DesignStraub/ringwheel-hybrid-drone/docs/Kostenliste.md

# Kostenliste Hybrid-Drohne (Stand 26.10.2026, mit FPV-Kamera und Fahrgetriebe 1:4)

Preise inkl. 19 % MwSt., ohne Versand, wenn nicht anders vermerkt. Live von den Shopseiten abgerufen; nichts bestellt.
USD-Preise umgerechnet mit 1 EUR = 1,1193 USD (EZB, 23.10.2026).
**verifiziert** = Preis auf der Produktseite gesehen, **Suchliste** = Preis aus der Shop-Suche, **geschätzt** = kein Seitenpreis.

## Pflichtteile

| # | Menge | Produkt | Shop | € gesamt | Status |
|---|---|---|---|---|---|
| 1 | 4 | iFlight XING 2306 2450KV (4S) | [FPV24](https://www.fpv24.com/en/iflight/iflight-xing-2306-2450kv-4s-unibell-camo-racing-motor) | 62,00 | verifiziert |
| 2 | 2 Sätze | Gemfan Hurricane 51466-3 (5,1", 3-Blatt) | [FPV24](https://www.fpv24.com/en/gemfan/gemfan-hurricane-mck-51466-3-3-blade-propeller-51-inch-wave-blue) | 5,98 | verifiziert |
| 3 | 1 | Flywoo GOKU F722 Pro V2 55A Stack 30×30 (AM32 oder BLHeli_32) | [N-Factory](https://n-factory.de/Flywoo-GOKU-F722-Pro-V2-55A-30x30-AM32-Stack-3-6S) | 88,90 | verifiziert |
| 4 | 1 | BetaFPV ELRS Nano Empfänger | [FPV24](https://www.fpv24.com/de/betafpv/betafpv-elrs-nano-receiver) | 12,50 | verifiziert |
| 5 | 2 | BosLipo P7 4S 1300 mAh XT60 | [FPV24](https://www.fpv24.com/de/boslipo/boslipo-p7-batterie-1300mah-148v-4s-150c-lipo-akku-xt60-plug) | 57,80 | verifiziert |
| 6 | 2× 2er-Pack | N20-Getriebemotor 6 V, 300 U/min | [Amazon](https://www.amazon.de/dp/B0HNJ9TCYX) | 26,86 | verifiziert |
| 7 | 4 Sätze | **Empfohlen:** Messing-Schneckengetriebe M0,5, 1:30 (passt exakt zur Konstruktion) | [AliExpress](https://de.aliexpress.com/item/1005008696341485.html) | ≈ 47,08 | verifiziert, + Zoll |
| 7 alt. | je 4 | Mädler Schnecke Stahl 30000000 + Schneckenrad Bronze 25 Z 30001000 (i = 25, 17 % weniger Moment) | [Mädler](https://www.maedler.de/Article/30001000) | 144,84 | verifiziert, netto + MwSt. |
| 8 | 1 m | Alu-Rundrohr 12×1 | [Hornbach](https://www.hornbach.de/p/rundrohr-alu-natur-o-12-mm-1-m/8829152/) | 3,65 | verifiziert |
| 9 | 300 mm | Welle 6 mm h6 (gehärtet; ungehärtet C45 1 m: 9,78 €) | [Amazon](https://www.amazon.de/dp/B07GKJJZXK) | 5,34 | verifiziert |
| 10a | 10 Stk | Neodym diametral Ø 6×2 (für AS5600) | [AliExpress](https://de.aliexpress.com/item/1005012687239354.html) | 2,69 | Variantenpreis nicht geprüft |
| 10b | 4 Stk | Ringmagnet NdFeB axial ca. Ø 16 × Ø 12,5 × 1 mm (Hall-Geber auf der Muffennabe; ersatzweise 6 Scheiben Ø 1,5 × 1 mm je Muffe) | – | ≈ 6 | **geschätzt**, genaue Größe in keinem Shop gefunden |
| 10c | 12 Stk | Zylinderstift Ø 2,5 × 8 mm, ISO 8734 (Planetenbolzen) | – | ≈ 5 | **geschätzt** |
| 11 | 100 g | Kupferlackdraht 0,25 mm (Hubmagnet-Spulen) | [Amazon](https://www.amazon.de/dp/B08CVHQH67) | 13,99 | verifiziert |
| 12 | 5 Stk | Scheiben DIN 125 M12 Stahl (Anker) | [Amazon](https://www.amazon.de/dp/B0CJZFXLSX) | 4,11 | verifiziert |
| 13 | 5 Stk | Druckfeder 1,0 × AD 20 × 25 mm | [Amazon](https://www.amazon.de/dp/B0CL9SKV5J) | 5,69 | verifiziert |
| 14 | 4 | igus iglidur G GSM-1214-10 (Gleitlager Muffe) | [igus](https://www.igus.de/iglidur-ibh/zylindrische-gleitlager/product-details/iglidur-g-m?artnr=GSM-1214-10) | 12,09 | verifiziert, netto + MwSt. |
| 15 | 1 | Nylon-Schrauben/Abstandsbolzen-Sortiment M2–M4 | [Amazon](https://www.amazon.de/dp/B0CLD4DVVY) | 16,99 | verifiziert |
| 16a | 1 | Silikonkabel 20 AWG rot/schwarz | [Amazon](https://www.amazon.de/dp/B0CRVN1QTY) | 6,49 | verifiziert |
| 16b | 1 | Silikonkabel 28 AWG rot/schwarz | [Amazon](https://www.amazon.de/dp/B0CRVKW33H) | 6,49 | verifiziert |
| 16c | 1 Kit | JST-GH 1,25 Kit (vorgecrimpt, Gehäuse 2–10 pol) | [Amazon](https://www.amazon.de/dp/B07PBHN7TM) | 18,99 | verifiziert |
| 16d | 1 Kit | JST-SH 1,0 Kit (vorgecrimpt, Gehäuse 3–12 pol) | [Amazon](https://www.amazon.de/dp/B07PDQKHJ2) | 17,99 | verifiziert |
| 16e | 1 Paar | XT60H | [Amazon](https://www.amazon.de/dp/B07C3MCM8R) | 3,98 | verifiziert |
| 17a | 1 kg | Bambu Lab PA6-GF (Nylon, glasfaserverstärkt) | [3DJake](https://www.3djake.de/bambu-lab/pa6-gf-black) | 62,99 | Suchliste |
| 17b | 1 kg | Elegoo TPU 95A | [3DJake](https://www.3djake.de/elegoo/tpu-white-3) | 17,99 | Suchliste |
| 18 | | **Platinen + Bestückung JLCPCB**: Hybrid-Controller (4 Lagen, 2 bestückt), 5 Eckplatinen, DHL inkl. EUSt (Muffensensor MS-1 entfällt ab v13) | [JLCPCB](https://cart.jlcpcb.com/quote) | ≈ 230,49 | **geschätzt** |
| 18a | | Zuschlag Bestückung: Der fertige Hybrid-Controller hat 42 statt der angenommenen 32 Bauteiltypen | JLCPCB | ≈ 16 | **geschätzt** |
| 19 | 1 | **DJI O4 Air Unit Lite** (Kamera + Videosender, 9,95 g, 30 × 30 mm, 3,7–13,2 V) | [FPV24](https://fpv24.com/en/dji/dji-o4-air-unit-fpv-lufteinheit) | 115,00 | verifiziert 26.10., **derzeit nur vorbestellbar** |
| 20 | | Kleinkram: Akku-Klettband, Schrumpfschlauch, Lötzinn | – | ≈ 10 | **geschätzt** |

| Summe Drohne (alles, was verbaut wird) | € |
|---|---|
| Teile 1–17 mit AliExpress-Schneckengetrieben | ≈ 511 |
| Platinen JLCPCB inkl. Zuschlag (geschätzt) | ≈ 246 |
| FPV-Kamera und -Sender DJI O4 Lite | 115 |
| Kleinkram (geschätzt) | ≈ 10 |
| Versand übrige Shops + Zoll (geschätzt) | ≈ 29 |
| **Drohne gesamt (empfohlene Variante)** | **≈ 910 €** |
| Drohne gesamt mit Mädler-Getrieben | ≈ 1.010 € |

## Ausrüstung (nur falls noch nicht vorhanden)

| Produkt | Shop | € |
|---|---|---|
| **DJI Goggles N3** (FPV-Brille, passt zur O4) | [FPV24](https://www.fpv24.com/en/dji/dji-fpv-goggles-n3-video-goggles-hd) | 269,00 (verifiziert 26.10.; im Preisvergleich ab ca. 246 €) |
| RadioMaster Pocket CRUSH ELRS (ohne 18650-Akkus) | [FPV24](https://www.fpv24.com/en/radiomaster/radiomaster-pocket-crush-elrs-fpv-remote-control-slate-grey) | 84,90 |
| 2× 18650-Akku für die Pocket | – | ≈ 12 (geschätzt) |
| ToolkitRC M6AC Ladegerät mit Netzteil | [N-Factory](https://n-factory.de/ToolkitRC-M6AC-LiPo-1-6S-15A-AC-DC-charger-with-power-supply-unit) | 63,95 |
| **Summe Ausrüstung** | | **≈ 430 €** |

**Komplett mit Brille, Fernsteuerung und Ladegerät: ≈ 1.340 €.**

## Gegencheck 26.10.2026 (Design gegen diese Liste)

- **Platinen:** Die Stücklisten aus KiCad (Hybrid-Controller 97 Bauteile, Eckplatine 8, Muffensensor 2) passen 1:1 zu den Bestückungsdateien. Alle ICs und Stecker haben LCSC-Nummern. Für 26 Typen Kleinteile beim Hybrid-Controller (Widerstände, Kondensatoren, Dioden, Spule, Sicherung, USB-C, Taster) und 4 bei der Eckplatine wählt man die Teile im JLCPCB-Bestücktool aus. Fast alles davon sind „Basic Parts“ ohne Aufpreis.
- **Mechanik aus Fusion:** Alle gekauften Teile stehen in der Liste (Motoren, Propeller, N20, Schnecken und Räder, Bolzen aus der 6-mm-Welle, Alu-Rohr, Spulendraht, Anker-Scheiben, Federn, Gleitlager, Magnete, Stack, Empfänger, Akku). Die **vier Motorplatten** sind im Modell aus Alu, aber nicht in der Liste. Am einfachsten aus PA6-GF mitdrucken, das kostet nichts extra.
- **Via im Pad:** Bei den Pads unter dem ESP32, an C24 und U3 gibt es bei JLCPCB die Option „Via-in-Pad, gefüllt und abgedeckt“. Bei 4 Lagen kostet sie Aufpreis, den Betrag zeigt das Angebot. Man kann auch ohne bestellen und die zwei kleinen Lötstellen von Hand nacharbeiten.
- **Spannbreite:** JLCPCB-Coupons sparen 8–25 €. Ein 2er-Nutzen mit 4 statt 2 bestückten Controllern kostet bis zu 45 € mehr.
- **Fahrgetriebe (ab v13):** Sonne, Planeten, Hohlrad und die Radnabe mit Planetenträger werden aus dem PA6-GF mitgedruckt, das sind etwa 70 g mehr Nylon. Die Zähne haben Modul 0,7. Mit 0,4-mm-Düse geht das, mit 0,2-mm-Düse werden die Flanken sauberer. Gekauft werden nur Zylinderstifte und Ringmagnete (10b, 10c). Die Neodym-Scheiben Ø 3 × 2 für den alten Muffensensor entfallen.
- **Was übrig bleibt:** 3 unbestückte Controller-Platinen, 1 Eckplatine als Ersatz, ein zweiter Akku, ca. 680 g Nylon und 950 g TPU sowie die Sortimente.

## Platinen im Detail (JLCPCB, geschätzt)

| Platine | Lagen / Größe | Stück | € inkl. EUSt |
|---|---|---|---|
| Hybrid-Controller HC-1 | 4 Lagen, 62 × 42 mm | 5 PCB, 2 bestückt | ≈ 163 |
| Eckplatine EP-1 | 2 Lagen, 24 × 24 mm | 5 bestückt | ≈ 38 |
| Muffensensor MS-1 | entfällt ab v13 (Hall-Sensor sitzt einzeln in der Spulenbohrung) | – | 0 |
| Versand DHL + EUSt | | | ≈ 29 |

Bauteilkosten allein (LCSC, netto, nur zur Info, in der Bestückung enthalten): ≈ 42 €.

## Vor der Bestellung beachten

- **USB-C-Buchse:** Die ursprünglich geplante GCT USB4105 ist bei JLCPCB/LCSC ausverkauft. Im Design ist sie deshalb schon durch die **HRO TYPE-C-31-M-12** ersetzt (gängig, günstig; LCSC-Nummer beim Bestellen prüfen).
- **Mindestgröße Bestückung:** JLCPCB bestückt Standard-PCBA laut Capabilities erst ab 70 × 70 mm. Den Hybrid-Controller als 2er-Nutzen bestellen. Werden dabei 4 statt 2 Boards bestückt, kommen ca. 40–45 € dazu.
- **Knappe Teile:** ESP32-S3-MINI-1-N8, AP63200WU-7 (nur 266 Stück) und AS5600 gibt es nur noch bei JLCPCB, bei LCSC nicht.
- **Stack-Firmware:** Der Flywoo-Stack kommt je nach Charge mit AM32 oder BLHeli_32. Beide können Drehrichtungsumkehr per DShot und bidirektionales DShot. AM32 ist die zukunftssichere Wahl.
- **Zoll:** Seit 1.7.2026 fallen bei Sendungen unter 150 € pauschal 3 € Zoll pro Warenposition an (AliExpress). Die JLCPCB-Bestellung liegt darüber; dann zahlt man 19 % EUSt.
- **Netto-Shops:** Mädler und igus zeigen Nettopreise. Oben ist die MwSt. schon aufgeschlagen.
- **Coupons:** JLCPCB gibt regelmäßig Coupons aus (8–25 $). Die sind nicht eingerechnet.
