DesignStraub/ringwheel-hybrid-drone/docs/images/drive_gear_module.png

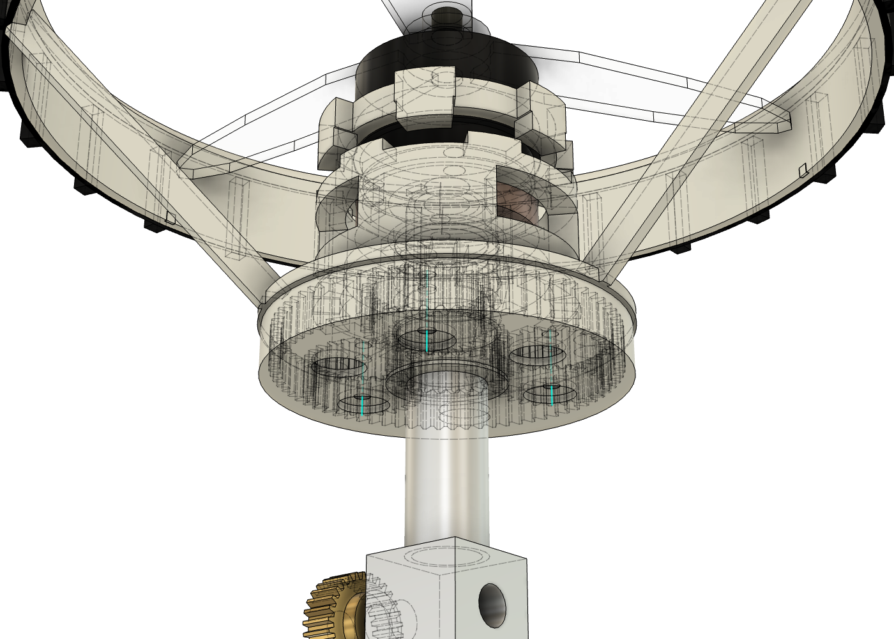
docs/images/drive_gear_module.png
