DesignStraub/ringwheel-hybrid-drone/docs/images/drive_gear_teeth.png

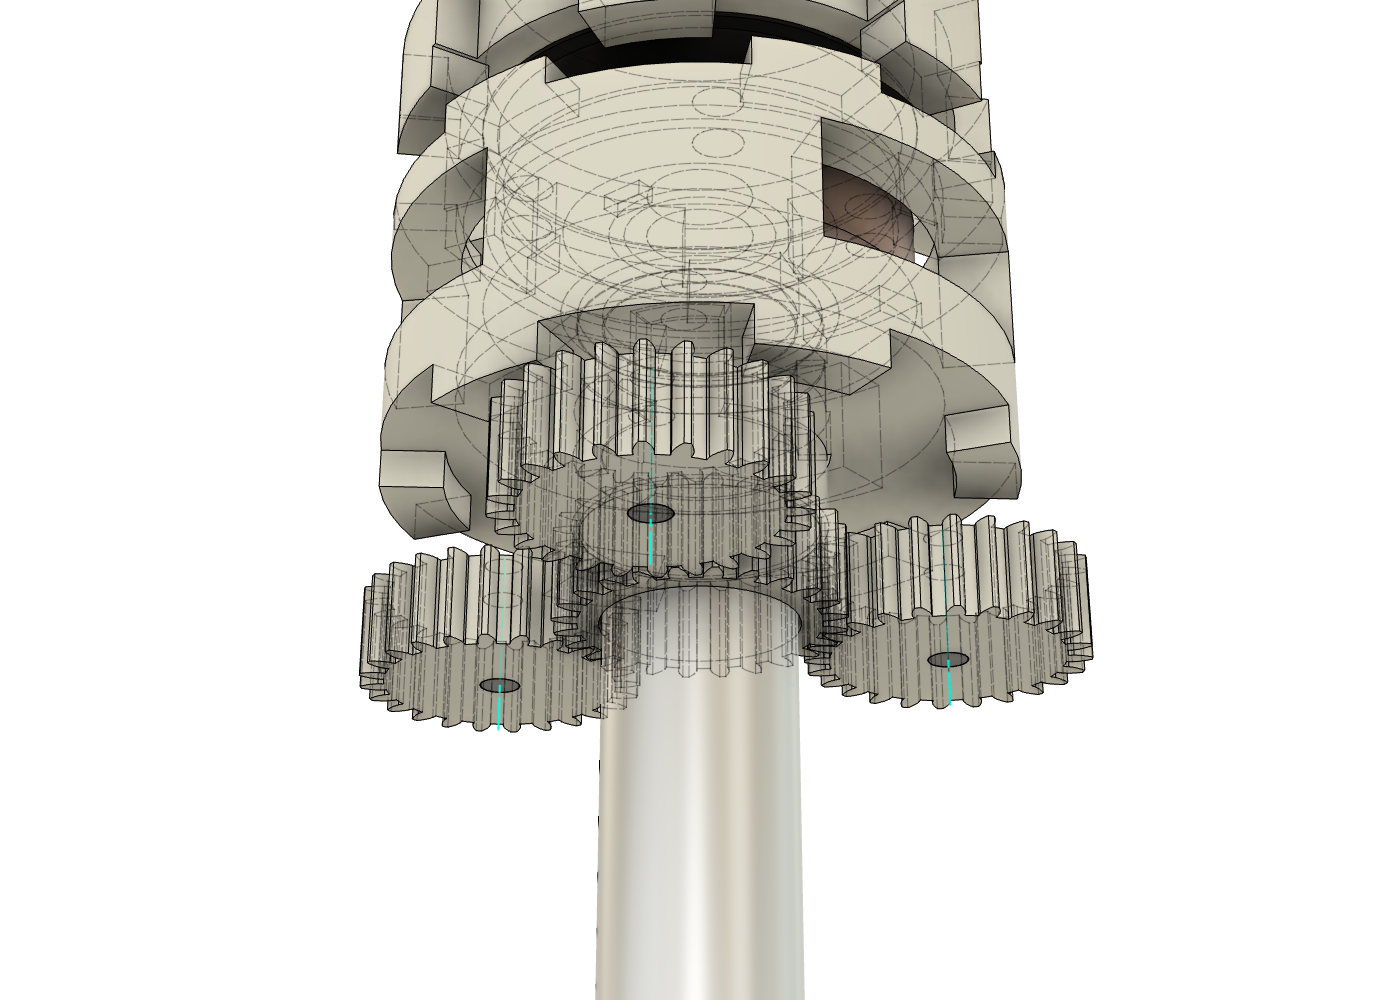
docs/images/drive_gear_teeth.png
