DesignStraub/ringwheel-hybrid-drone/electronics/Hybrid-Controller/HC-1_oben.png

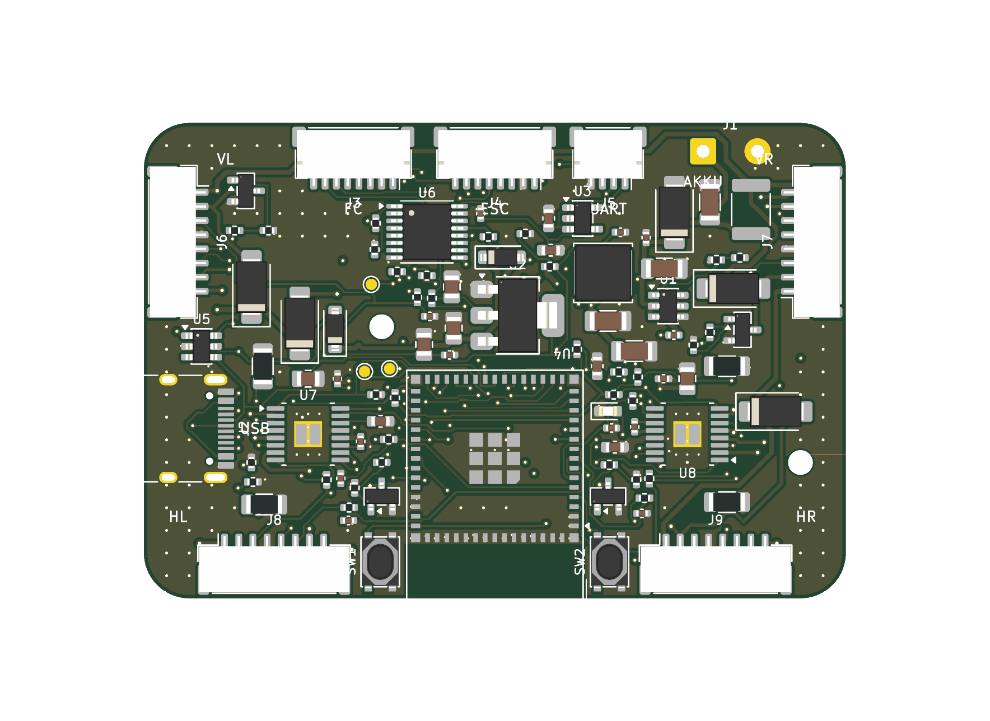
electronics/Hybrid-Controller/HC-1_oben.png
