DesignStraub/ringwheel-hybrid-drone/electronics/Hybrid-Controller/HC-1_unten.png

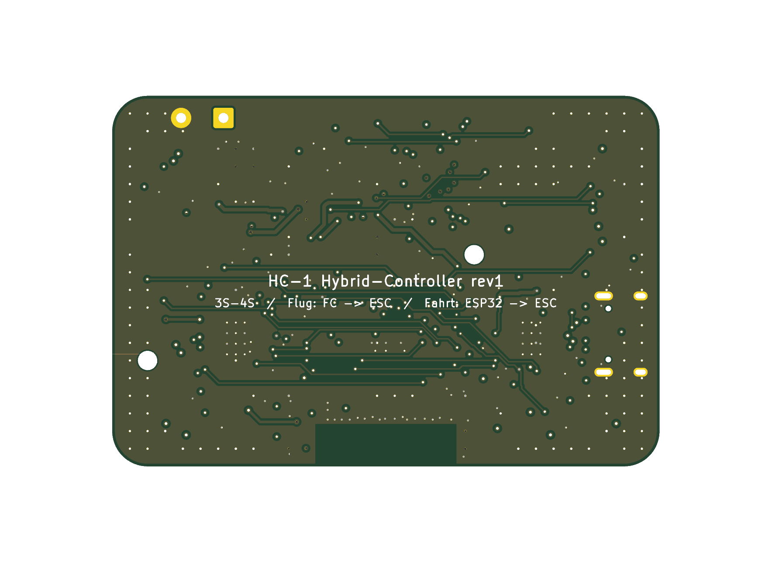
electronics/Hybrid-Controller/HC-1_unten.png
