DesignStraub/ringwheel-hybrid-drone/electronics/Fertigung/Hybrid-Controller_BOM_JLCPCB.csv

Comment | Designator | Footprint | LCSC Part #
10uF 35V | C1,C2 | C_1206_3216Metric
10uF | C11 | C_0805_2012Metric
10nF 16V | C16,C20 | C_0402_1005Metric
2.2uF | C17,C21 | C_0603_1608Metric
100nF 50V | C3 | C_0402_1005Metric
100nF | C4,C12,C13,C15,C19,C23,C24,C25,C26,C27,C28 | C_0402_1005Metric
22uF 16V | C5,C6 | C_1206_3216Metric
10uF 16V | C7,C18,C22 | C_0805_2012Metric
22uF 10V | C8 | C_0805_2012Metric
1uF | C9,C10,C14 | C_0603_1608Metric
SMAJ20CA | D1 | D_SMA
B5819W | D2,D3 | D_SOD-123
SS34 | D4,D5,D6,D7 | D_SMA | C8678
2A hold (Hubmagnete) | F1 | Fuse_1812_4532Metric
USB-C | J2 | USB_C_Receptacle_HRO_TYPE-C-31-M-12
vom FC (ESC-Port) | J3 | JST_SH_SM08B-SRSS-TB_1x08-1MP_P1.00mm_Horizontal | C160407
zum 4-in-1-ESC | J4 | JST_SH_SM08B-SRSS-TB_1x08-1MP_P1.00mm_Horizontal | C160407
FC UART (MSP) | J5 | JST_SH_SM04B-SRSS-TB_1x04-1MP_P1.00mm_Horizontal | C160404
Ecke VL | J6 | JST_GH_SM08B-GHS-TB_1x08-1MP_P1.25mm_Horizontal | C265111
Ecke VR | J7 | JST_GH_SM08B-GHS-TB_1x08-1MP_P1.25mm_Horizontal | C265111
Ecke HL | J8 | JST_GH_SM08B-GHS-TB_1x08-1MP_P1.25mm_Horizontal | C265111
Ecke HR | J9 | JST_GH_SM08B-GHS-TB_1x08-1MP_P1.25mm_Horizontal | C265111
10uH 3A (FNR5040S100MT) | L1 | L_Changjiang_FNR5040S
gruen | LED1 | LED_0603_1608Metric
AO3400A | Q1,Q2,Q3,Q4 | SOT-23 | C20917
64.9k 1% | R1 | R_0402_1005Metric
0.2R 1/4W | R14,R15,R16,R17 | R_1206_3216Metric
10k 1% | R2,R37 | R_0402_1005Metric
100R | R20,R22,R24,R26 | R_0402_1005Metric
10k | R3,R4,R9,R18,R19,R21,R23,R25,R27,R28,R30,R32,R34 | R_0402_1005Metric
100k 1% | R36 | R_0402_1005Metric
1k | R5,R8,R10,R11,R12,R13,R29,R31,R33,R35 | R_0402_1005Metric
5.1k | R6,R7 | R_0402_1005Metric
RESET | SW1 | SW_SPST_PTS810
BOOT | SW2 | SW_SPST_PTS810
AP63200WU (6,0 V / 2 A) | U1 | TSOT-23-6 | C2071868
AMS1117-3.3 | U2 | SOT-223-3_TabPin2 | C6186
AP2112K-3.3 | U3 | SOT-23-5 | C51118
ESP32-S3-MINI-1-N8 | U4 | ESP32-S2-MINI-1 | C2913206
USBLC6-2SC6 | U5 | SOT-23-6 | C7519
SN74CBTLV3257PW | U6 | TSSOP-16_4.4x5mm_P0.65mm | C7637
DRV8833PWPR | U7,U8 | HTSSOP-16-1EP_4.4x5mm_P0.65mm_EP3.4x5mm_Mask2.46x2.31mm_ThermalVias | C50506
