DesignStraub/ringwheel-hybrid-drone/cad/Drohne_Hybid_Car_v15.step

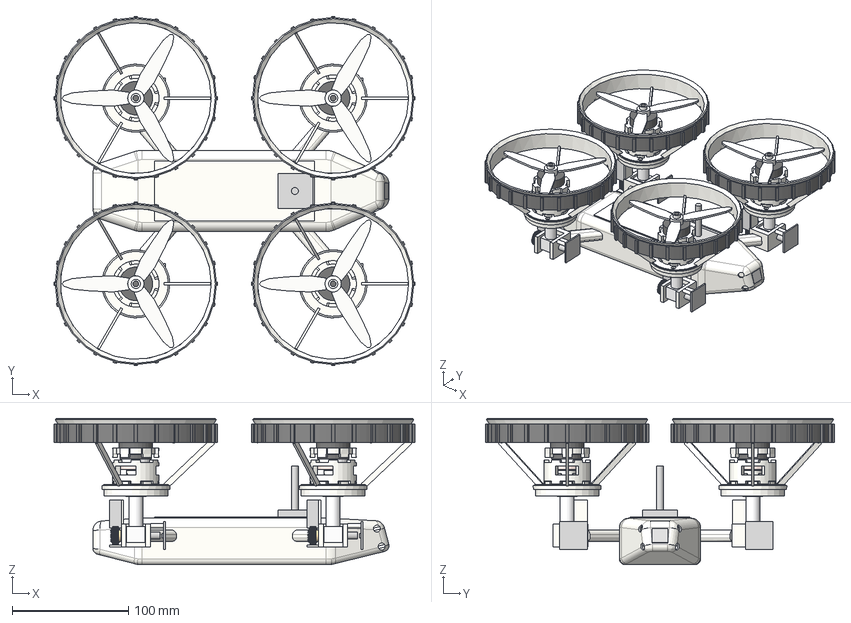
[picture p8: CAD file, 2026-10-28]
cad/Drohne_Hybid_Car_v15.step
311.0 x 301.0 x 126.0 mm
C_1206_3216Metric_1 x 4
LED_0603_1608Metric_1
JST_SM08B_GHS_TB x 4
C_0402_1005Metric_1 x 14
C_0603_1608Metric_1 x 5
D_SOD-123_1 x 2
C_0805_2012Metric_1 x 5
R_0402_1005Metric_1 x 33
SW_SPST_PTS810_1 x 2
SOT-23-5_1
JST_SH_SM08B-SRSS-TB_1x08-1MP_P1.00mm_Horizontal_1 x 2
SOT-23_1 x 4
D_SMA_1 x 5
R_1206_3216Metric_1 x 4
TSOT-23-6_1
TSSOP-16_4.4x5mm_P0.65mm_1
SOT-23-6_1
JST_SH_SM04B-SRSS-TB_1x04-1MP_P1.00mm_Horizontal_1
SOT-223_1
L_Changjiang_FNR5040S_1
Hybrid-Controller_PCB
