DesignStraub/ringwheel-hybrid-drone/electronics/STEP/Eckplatine.step

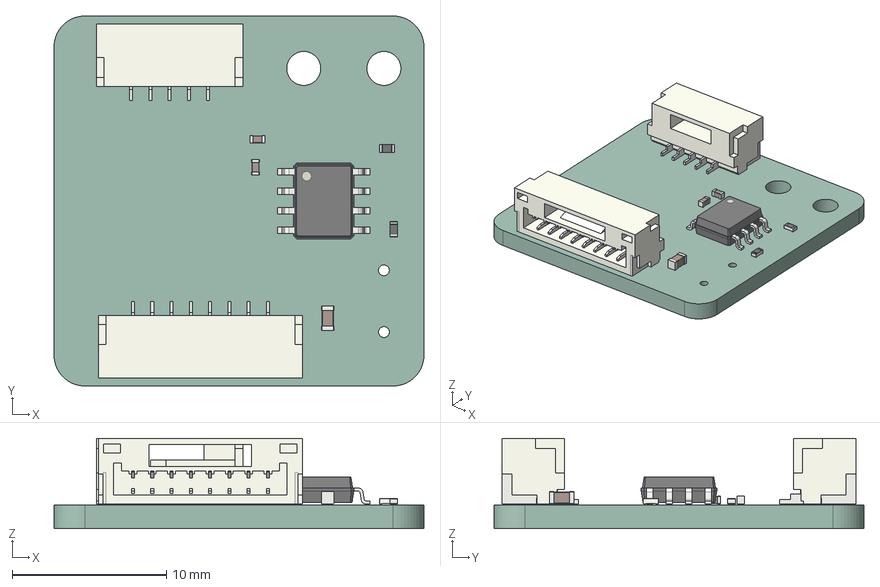
[picture p9: CAD file, 2026-10-28]
electronics/STEP/Eckplatine.step
24.0 x 24.0 x 5.84 mm
JST_SM05B_GHS_TB
R_0402_1005Metric x 2
SOIC-8_3.9x4.9mm_P1.27mm
C_0603_1608Metric
C_0402_1005Metric x 2
JST_SM08B_GHS_TB
Eckplatine_PCB
