DesignStraub/ringwheel-hybrid-drone/electronics/STEP/Hybrid-Controller.step

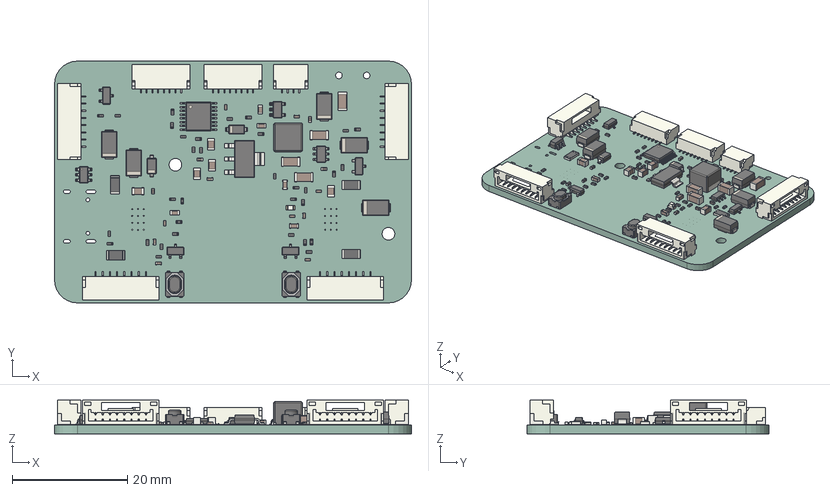
[picture p10: CAD file, 2026-10-28]
electronics/STEP/Hybrid-Controller.step
62.0 x 42.0 x 5.84 mm
C_1206_3216Metric x 4
LED_0603_1608Metric
JST_SM08B_GHS_TB x 4
C_0402_1005Metric x 14
C_0603_1608Metric x 5
D_SOD-123 x 2
C_0805_2012Metric x 5
R_0402_1005Metric x 33
SW_SPST_PTS810 x 2
SOT-23-5
JST_SH_SM08B-SRSS-TB_1x08-1MP_P1.00mm_Horizontal x 2
SOT-23 x 4
D_SMA x 5
R_1206_3216Metric x 4
TSOT-23-6
TSSOP-16_4.4x5mm_P0.65mm
SOT-23-6
JST_SH_SM04B-SRSS-TB_1x04-1MP_P1.00mm_Horizontal
SOT-223
L_Changjiang_FNR5040S
Hybrid-Controller_PCB
