DesignStraub/ringwheel-hybrid-drone/(list of files, cad)

Other CAD files:
cad/Drohne_Hybid_Car_v11_rounded_hull.f3d
cad/Drohne_Hybid_Car_v15.f3d
