DesignStraub/ringwheel-hybrid-drone/electronics/Eckplatine/Eckplatine_Schaltplan.pdf

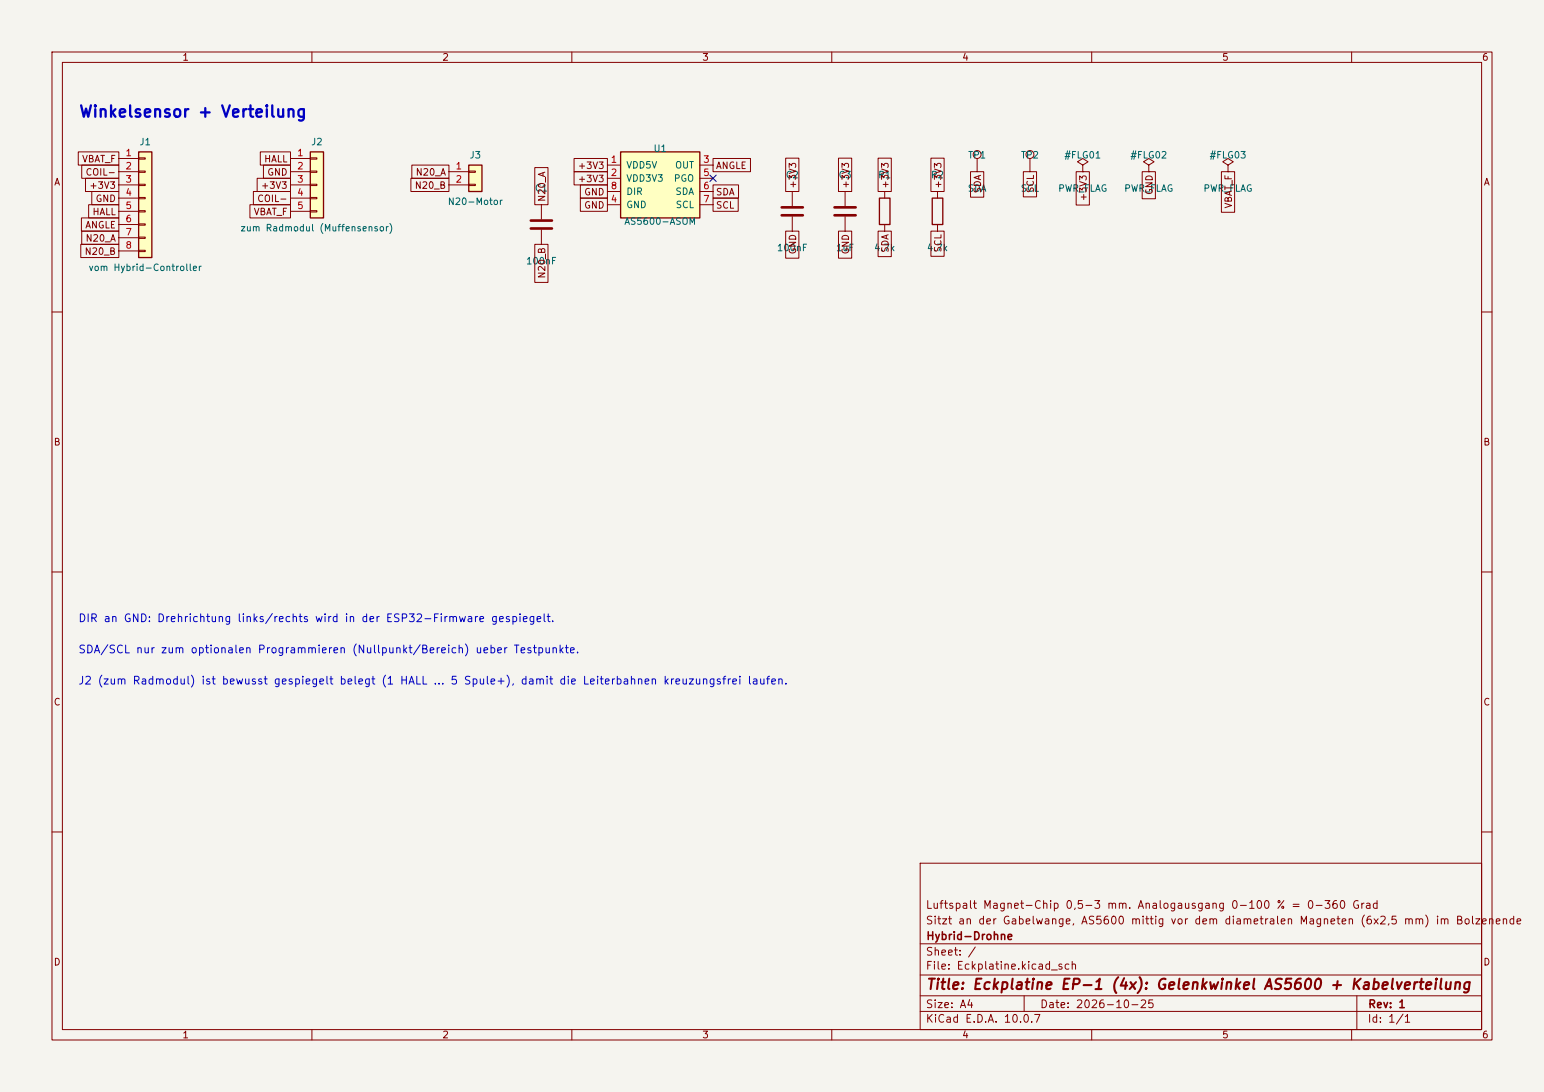
[picture p11: page 1]

DIR an GND: Drehrichtung links/rechts wird in der ESP32-Firmware gespiegelt.

SDA/SCL nur zum optionalen Programmieren (Nullpunkt/Bereich) ueber Testpunkte.

J2 (zum Radmodul) ist bewusst gespiegelt belegt (1 HALL ... 5 Spule+), damit die Leiterbahnen kreuzungsfrei laufen.

Luftspalt Magnet-Chip 0,5-3 mm. Analogausgang 0-100 % = 0-360 Grad
Sitzt an der Gabelwange, AS5600 mittig vor dem diametralen Magneten (6x2,5 mm) im Bolzenende
Hybrid-Drohne
Sheet: /
File: Eckplatine.kicad_sch
Title: Eckplatine EP-1 (4x): Gelenkwinkel AS5600 + Kabelverteilung

Size: A4 | Rev: 1
KiCad E.D.A. 10.0.7 | Id: 1/1
