DesignStraub/ringwheel-hybrid-drone/electronics/Eckplatine/Eckplatine.kicad_pcb

## KiCad design electronics/Eckplatine/Eckplatine.kicad_pcb (2026-10-28)

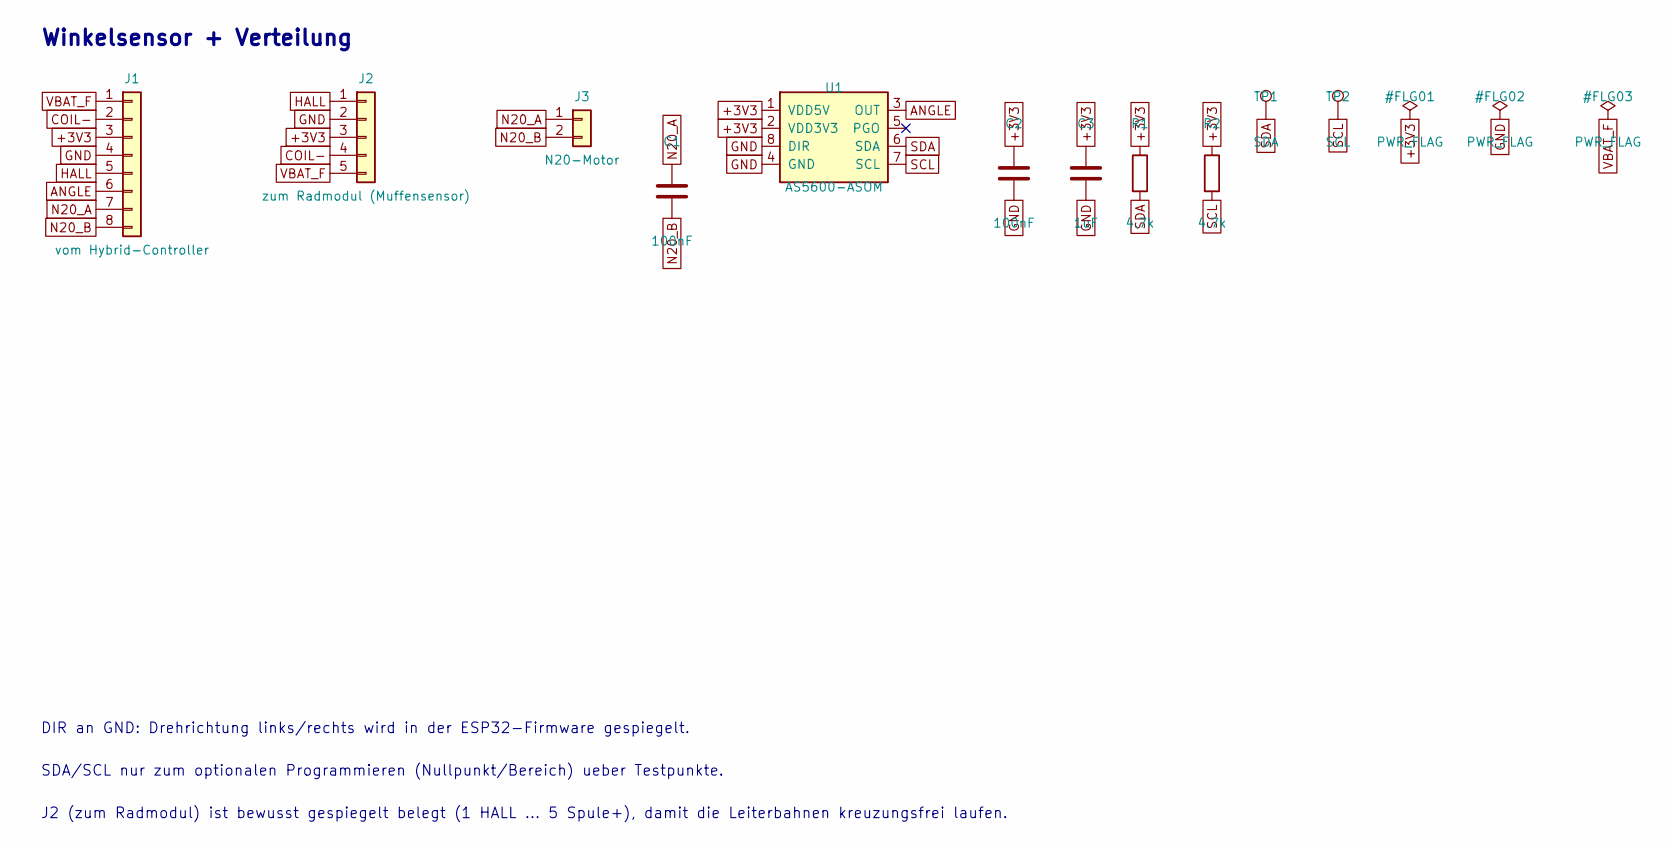
[picture p13: schematic Eckplatine.kicad_sch, Eckplatine EP-1 (4x): Gelenkwinkel AS5600 + Kabelverteilung]

Parts:
C1: 100nF; C_0603_1608Metric
C2: 100nF; C_0402_1005Metric
C3: 1uF; C_0402_1005Metric
J1: vom Hybrid-Controller; JST_GH_SM08B-GHS-TB_1x08-1MP_P1.25mm_Horizontal
J2: zum Radmodul (Muffensensor); JST_GH_SM05B-GHS-TB_1x05-1MP_P1.25mm_Horizontal
J3: N20-Motor; SolderWire-0.15sqmm_1x02_P4mm_D0.5mm_OD1.5mm
R1, R2: 4.7k; R_0402_1005Metric
TP1: SDA; TestPoint_Pad_D1.0mm
TP2: SCL; TestPoint_Pad_D1.0mm
U1: AS5600-ASOM; SOIC-8_3.9x4.9mm_P1.27mm

Connections:
+3V3: C2.1, C3.1, J1.3, J2.3, R1.1, R2.1, U1.1 (VDD5V), U1.2 (VDD3V3)
ANGLE: J1.6, U1.3 (OUT)
COIL-: J1.2, J2.4
GND: C2.2, C3.2, J1.4, J2.2, U1.4 (GND), U1.8 (DIR)
HALL: J1.5, J2.1
N20_A: C1.1, J1.7, J3.1
N20_B: C1.2, J1.8, J3.2
SCL: R2.2, TP2.1, U1.7 (SCL)
SDA: R1.2, TP1.1, U1.6 (SDA)
VBAT_F: J1.1, J2.5

Notes on the sheet:
Winkelsensor + Verteilung
J2 (zum Radmodul) ist bewusst gespiegelt belegt (1 HALL ... 5 Spule+), damit die Leiterbahnen kreuzungsfrei laufen.
DIR an GND: Drehrichtung links/rechts wird in der ESP32-Firmware gespiegelt.
SDA/SCL nur zum optionalen Programmieren (Nullpunkt/Bereich) ueber Testpunkte.

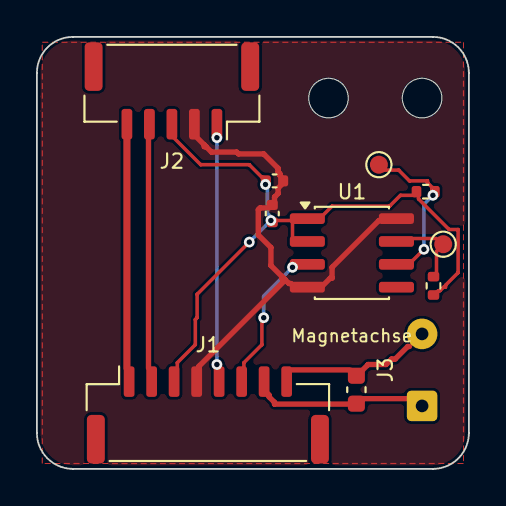
[picture p14: board Eckplatine.kicad_pcb from above]

Board: 2 copper layers, 24.0 x 24.0 mm, 13 parts (0 on the bottom side), 10 nets.

Other parts of the board:
H1, H2: MountingHole_2.2mm_M2
