DesignStraub/ringwheel-hybrid-drone/electronics/Hybrid-Controller/Hybrid-Controller.kicad_pcb

## KiCad design electronics/Hybrid-Controller/Hybrid-Controller.kicad_pcb (2026-10-28)

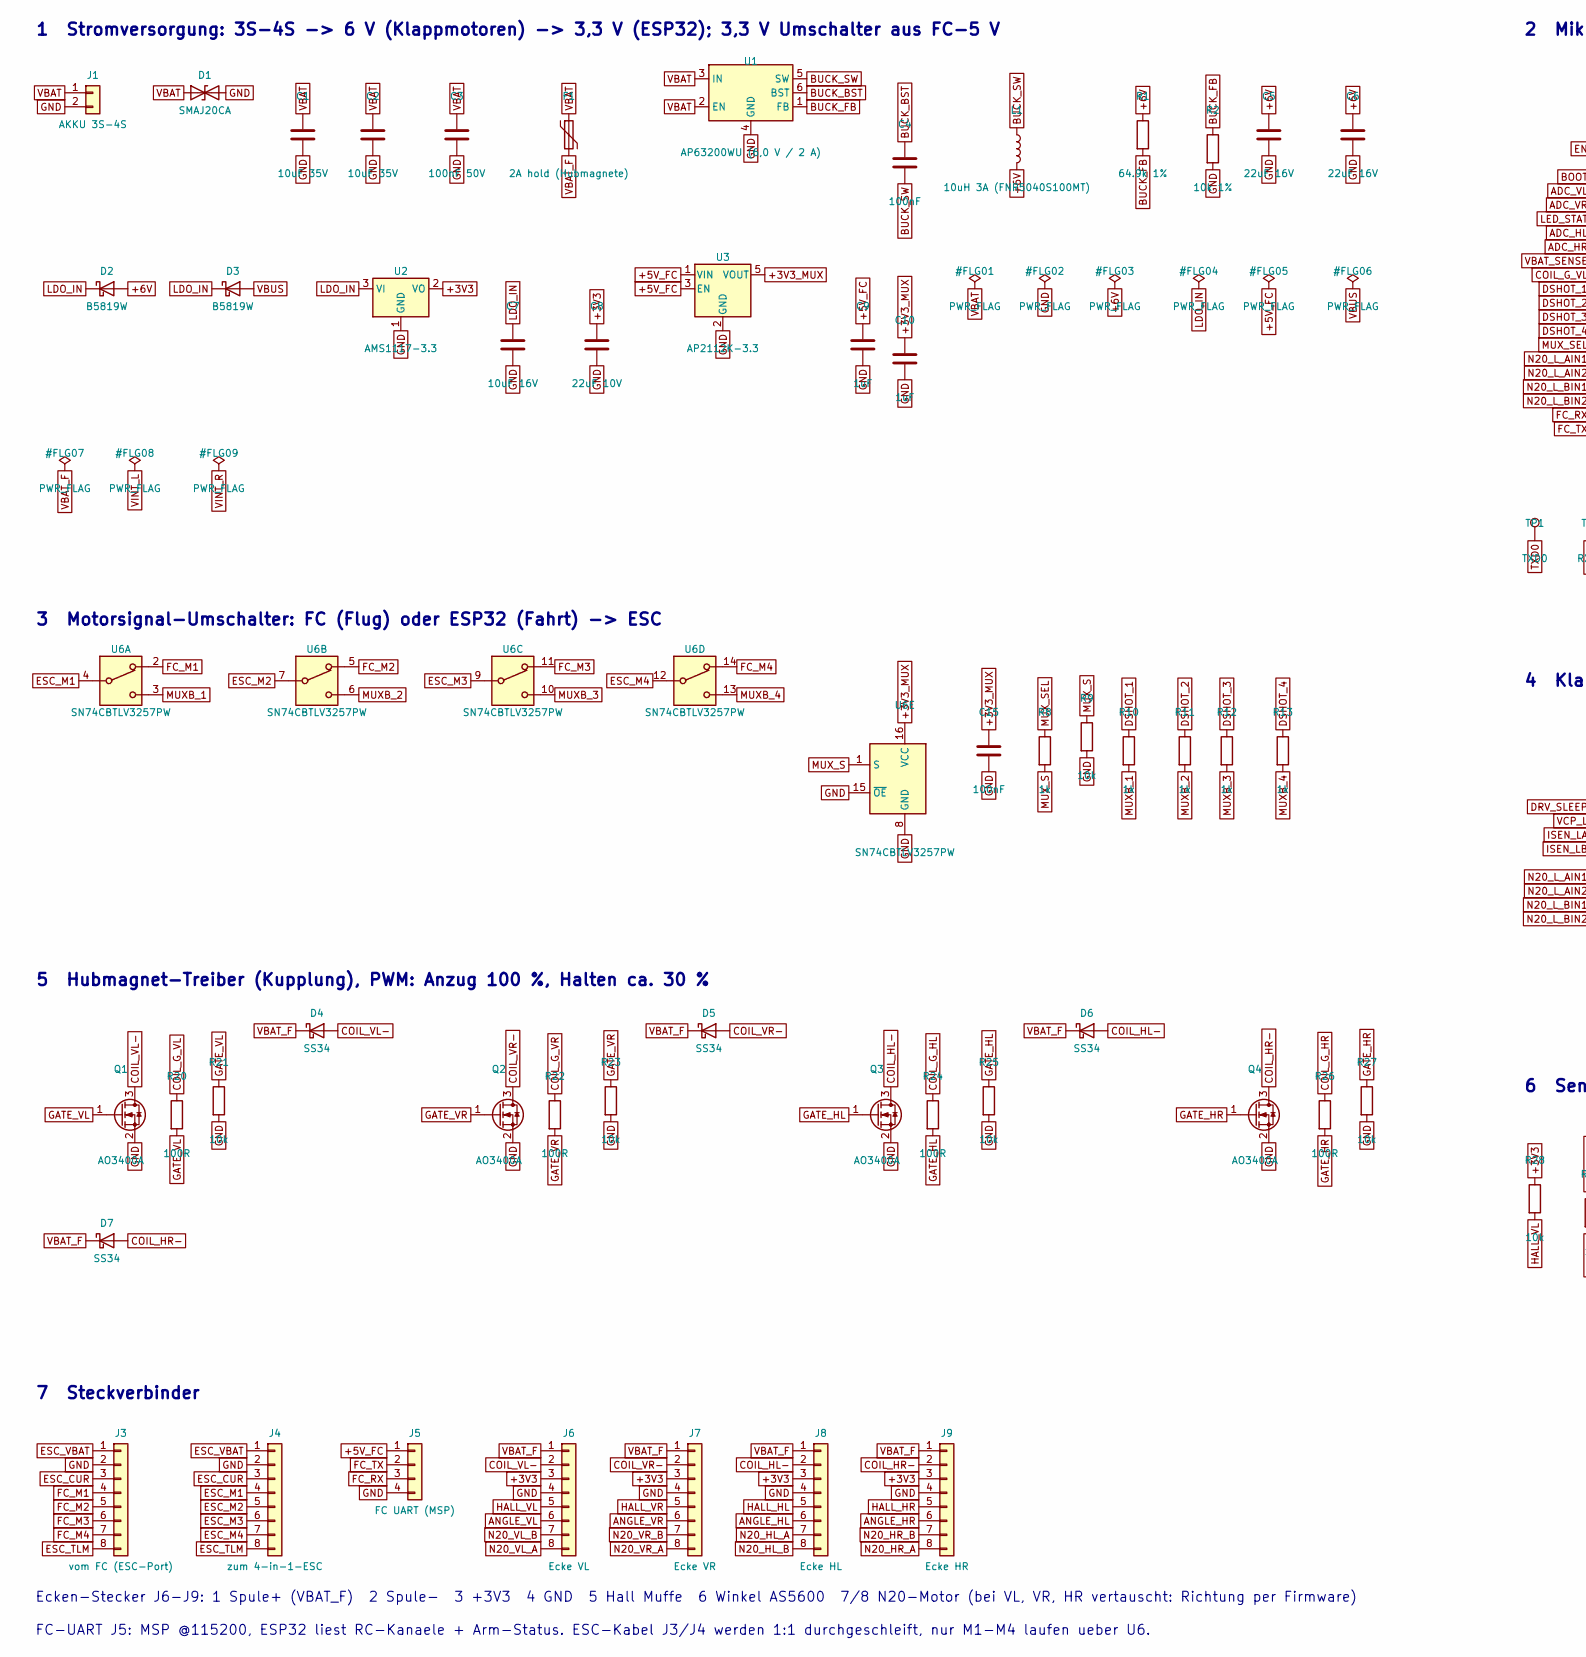
[picture p15: schematic Hybrid-Controller.kicad_sch, Hybrid-Controller HC-1 (Flug/Fahrt-Umschaltung), part in row 1, column 1]

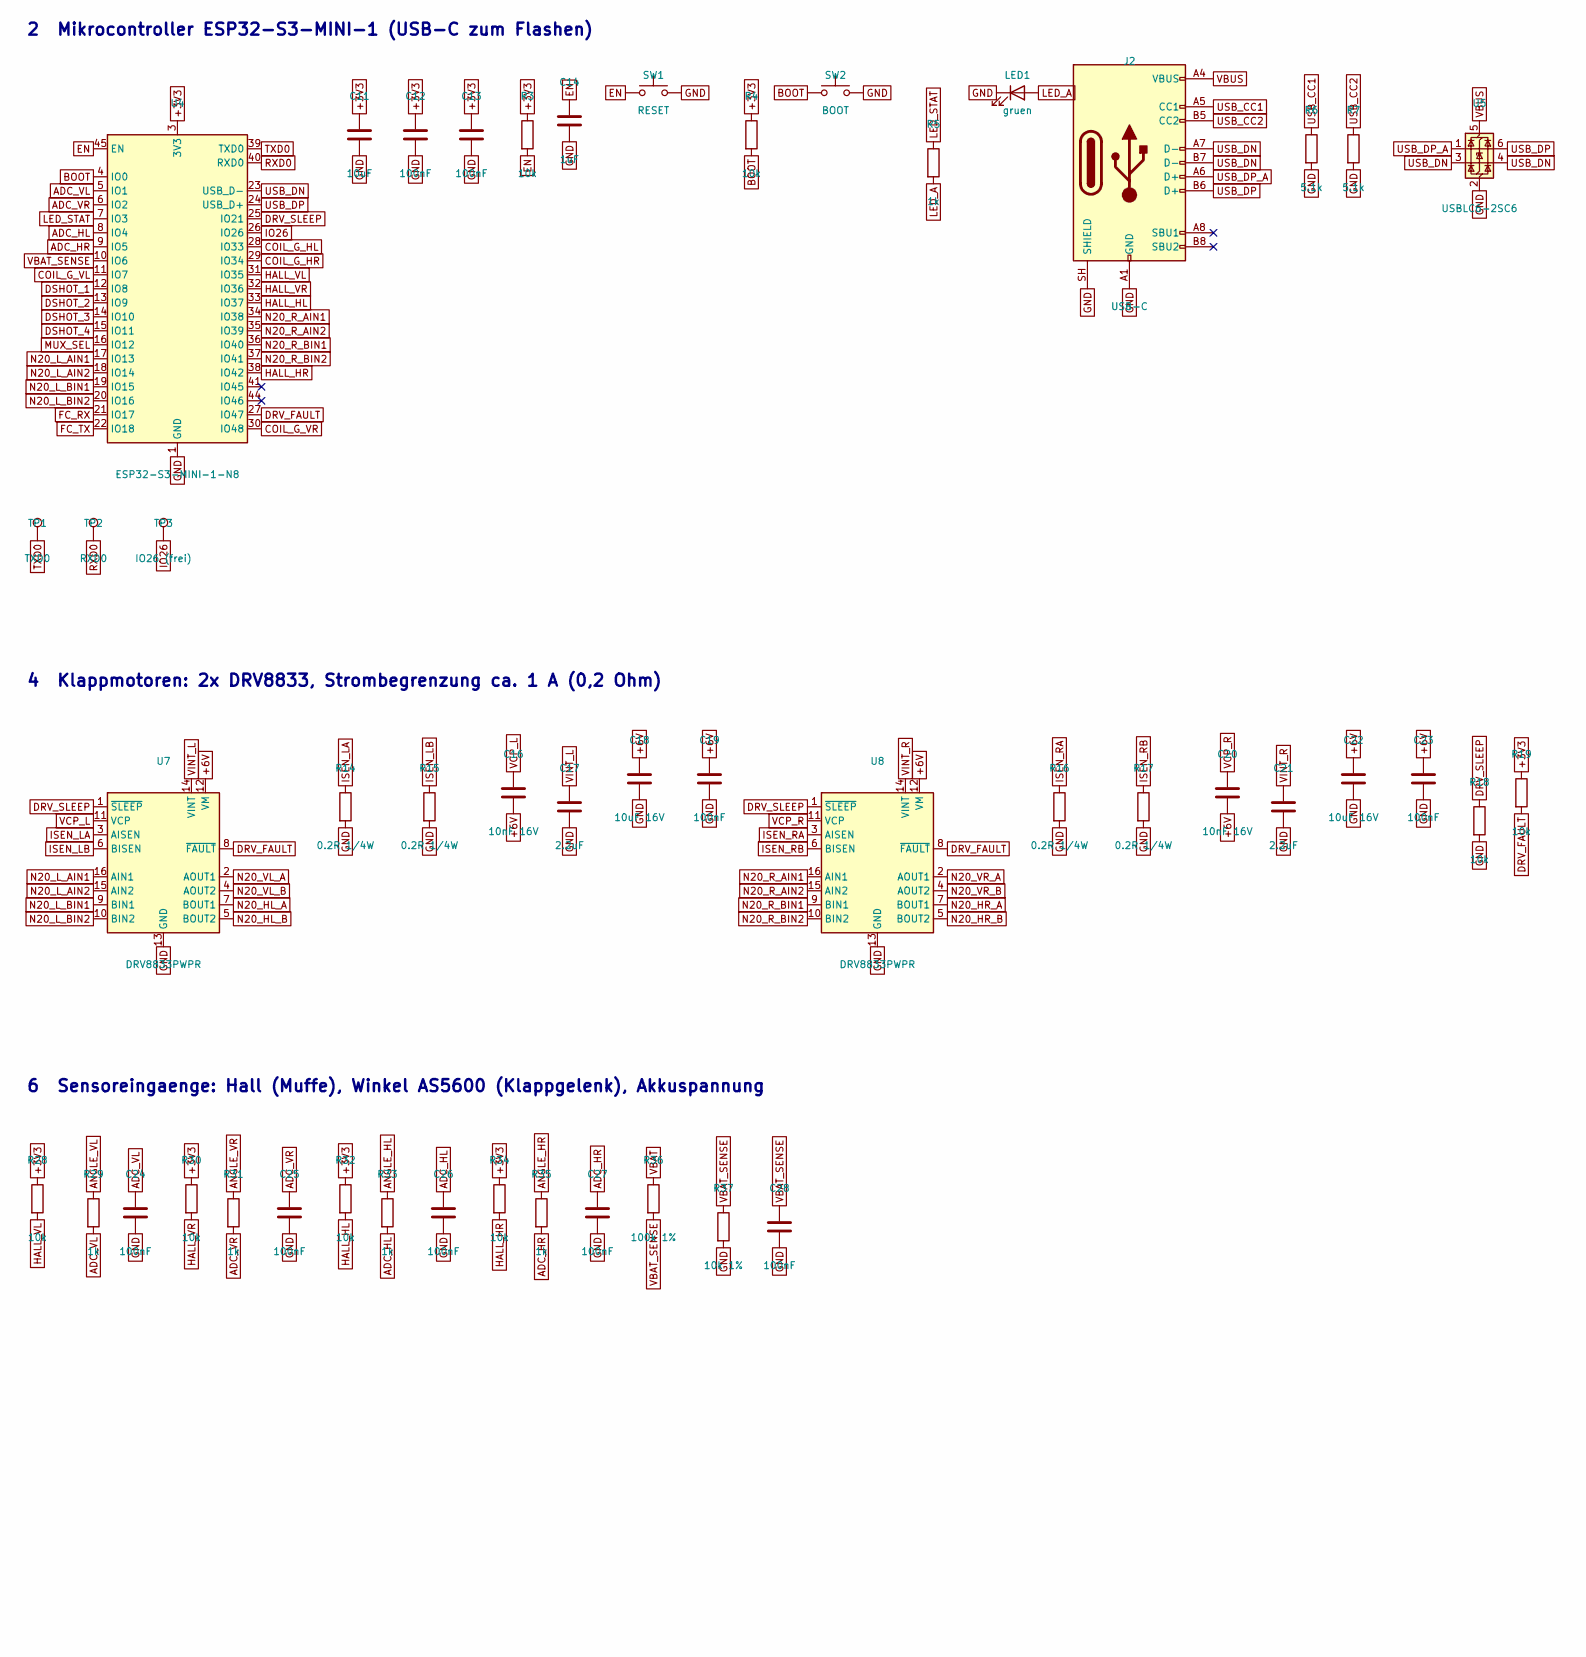
[picture p16: schematic Hybrid-Controller.kicad_sch, Hybrid-Controller HC-1 (Flug/Fahrt-Umschaltung), part in row 1, column 2]

Parts:
C1, C2: 10uF 35V; C_1206_3216Metric
C3: 100nF 50V; C_0402_1005Metric
C4, C12, C13, C15, C19, C23, C24, C25, C26, C27, C28: 100nF; C_0402_1005Metric
C5, C6: 22uF 16V; C_1206_3216Metric
C7, C18, C22: 10uF 16V; C_0805_2012Metric
C8: 22uF 10V; C_0805_2012Metric
C9, C10, C14: 1uF; C_0603_1608Metric
C11: 10uF; C_0805_2012Metric
C16, C20: 10nF 16V; C_0402_1005Metric
C17, C21: 2.2uF; C_0603_1608Metric
D1: SMAJ20CA; D_SMA
D2, D3: B5819W; D_SOD-123
D4, D5, D6, D7: SS34; D_SMA
F1: 2A hold (Hubmagnete); Fuse_1812_4532Metric
J1: AKKU 3S-4S; SolderWire-0.5sqmm_1x02_P4.8mm_D0.9mm_OD2.3mm
J2: USB-C; USB_C_Receptacle_HRO_TYPE-C-31-M-12
J3: vom FC (ESC-Port); JST_SH_SM08B-SRSS-TB_1x08-1MP_P1.00mm_Horizontal
J4: zum 4-in-1-ESC; JST_SH_SM08B-SRSS-TB_1x08-1MP_P1.00mm_Horizontal
J5: FC UART (MSP); JST_SH_SM04B-SRSS-TB_1x04-1MP_P1.00mm_Horizontal
J6: Ecke VL; JST_GH_SM08B-GHS-TB_1x08-1MP_P1.25mm_Horizontal
J7: Ecke VR; JST_GH_SM08B-GHS-TB_1x08-1MP_P1.25mm_Horizontal
J8: Ecke HL; JST_GH_SM08B-GHS-TB_1x08-1MP_P1.25mm_Horizontal
J9: Ecke HR; JST_GH_SM08B-GHS-TB_1x08-1MP_P1.25mm_Horizontal
L1: 10uH 3A (FNR5040S100MT); L_Changjiang_FNR5040S
LED1: gruen; LED_0603_1608Metric
Q1, Q2, Q3, Q4: AO3400A; SOT-23
R1: 64.9k 1%; R_0402_1005Metric
R2, R37: 10k 1%; R_0402_1005Metric
R3, R4, R9, R18, R19, R21, R23, R25, R27, R28, R30, R32, R34: 10k; R_0402_1005Metric
R5, R8, R10, R11, R12, R13, R29, R31, R33, R35: 1k; R_0402_1005Metric
R6, R7: 5.1k; R_0402_1005Metric
R14, R15, R16, R17: 0.2R 1/4W; R_1206_3216Metric
R20, R22, R24, R26: 100R; R_0402_1005Metric
R36: 100k 1%; R_0402_1005Metric
SW1: RESET; SW_SPST_PTS810
SW2: BOOT; SW_SPST_PTS810
TP1: TXD0; TestPoint_Pad_D1.0mm
TP2: RXD0; TestPoint_Pad_D1.0mm
TP3: IO26 (frei); TestPoint_Pad_D1.0mm
U1: AP63200WU (6,0 V / 2 A); TSOT-23-6
U2: AMS1117-3.3; SOT-223-3_TabPin2
U3: AP2112K-3.3; SOT-23-5
U4: ESP32-S3-MINI-1-N8; ESP32-S2-MINI-1
U5: USBLC6-2SC6; SOT-23-6
U6: SN74CBTLV3257PW; TSSOP-16_4.4x5mm_P0.65mm
U7, U8: DRV8833PWPR; HTSSOP-16-1EP_4.4x5mm_P0.65mm_EP3.4x5mm_Mask2.46x2.31mm_The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

Connections:
+3V3: C8.1, C11.1, C12.1, C13.1, J6.3, J7.3, J8.3, J9.3, R3.1, R4.1, R19.1, R28.1, R30.1, R32.1, R34.1, U2.2 (VO), U4.3 (3V3)
+3V3_MUX: C10.1, C15.1, U3.5 (VOUT), U6.16 (VCC)
+5V_FC: C9.1, J5.1, U3.1 (VIN), U3.3 (EN)
+6V: C5.1, C6.1, C16.2, C18.1, C19.1, C20.2, C22.1, C23.1, D2.2 (A), L1.2, R1.1, U7.12 (VM), U8.12 (VM)
ADC_HL: C26.1, R33.2, U4.8 (IO4)
ADC_HR: C27.1, R35.2, U4.9 (IO5)
ADC_VL: C24.1, R29.2, U4.5 (IO1)
ADC_VR: C25.1, R31.2, U4.6 (IO2)
ANGLE_HL: J8.6, R33.1
ANGLE_HR: J9.6, R35.1
ANGLE_VL: J6.6, R29.1
ANGLE_VR: J7.6, R31.1
BOOT: R4.2, SW2.1, U4.4 (IO0)
BUCK_BST: C4.1, U1.6 (BST)
BUCK_FB: R1.2, R2.1, U1.1 (FB)
BUCK_SW: C4.2, L1.1, U1.5 (SW)
COIL_G_HL: R24.1, U4.28 (IO33)
COIL_G_HR: R26.1, U4.29 (IO34)
COIL_G_VL: R20.1, U4.11 (IO7)
COIL_G_VR: R22.1, U4.30 (IO48)
COIL_HL-: D6.2 (A), J8.2, Q3.3 (D)
COIL_HR-: D7.2 (A), J9.2, Q4.3 (D)
COIL_VL-: D4.2 (A), J6.2, Q1.3 (D)
COIL_VR-: D5.2 (A), J7.2, Q2.3 (D)
DRV_FAULT: R19.2, U4.27 (IO47), U7.8 (~FAULT), U8.8 (~FAULT)
DRV_SLEEP: R18.1, U4.25 (IO21), U7.1 (~SLEEP), U8.1 (~SLEEP)
DSHOT_1: R10.1, U4.12 (IO8)
DSHOT_2: R11.1, U4.13 (IO9)
DSHOT_3: R12.1, U4.14 (IO10)
DSHOT_4: R13.1, U4.15 (IO11)
EN: C14.1, R3.2, SW1.1, U4.45 (EN)
ESC_CUR: J3.3, J4.3
ESC_M1: J4.4, U6.4
ESC_M2: J4.5, U6.7
ESC_M3: J4.6, U6.9
ESC_M4: J4.7, U6.12
ESC_TLM: J3.8, J4.8
ESC_VBAT: J3.1, J4.1
FC_M1: J3.4, U6.2
FC_M2: J3.5, U6.5
FC_M3: J3.6, U6.11
FC_M4: J3.7, U6.14
FC_RX: J5.3, U4.21 (IO17)
FC_TX: J5.2, U4.22 (IO18)
GATE_HL: Q3.1 (G), R24.2, R25.1
GATE_HR: Q4.1 (G), R26.2, R27.1
GATE_VL: Q1.1 (G), R20.2, R21.1
GATE_VR: Q2.1 (G), R22.2, R23.1
GND: C1.2, C2.2, C3.2, C5.2, C6.2, C7.2, C8.2, C9.2, C10.2, C11.2, C12.2, C13.2, C14.2, C15.2, C17.2, C18.2, C19.2, C21.2, C22.2, C23.2, C24.2, C25.2, C26.2, C27.2, C28.2, D1.2 (A2), J1.2, J2.A1 (GND), J2.A12 (GND), J2.B1 (GND), J2.B12 (GND), J2.SH (SHIELD), J3.2, J4.2, J5.4, J6.4, J7.4, J8.4, J9.4, LED1.1 (K), Q1.2 (S), Q2.2 (S), Q3.2 (S), Q4.2 (S), R2.2, R6.2, R7.2, R9.2, R14.2, R15.2, R16.2, R17.2, R18.2, R21.2, R23.2, R25.2, R27.2, R37.2, SW1.2, SW2.2, U1.4 (GND), U2.1 (GND), U3.2 (GND), U4.1 (GND), U4.2 (GND), U4.42 (GND), U4.43 (GND), U4.46 (GND), U4.47 (GND), U4.48 (GND), U4.49 (GND), U4.50 (GND), U4.51 (GND), U4.52 (GND), U4.53 (GND), U4.54 (GND), U4.55 (GND), U4.56 (GND), U4.57 (GND), U4.58 (GND), U4.59 (GND), U4.60 (GND), U4.61 (GND), U4.62 (GND), U4.63 (GND), U4.64 (GND), U4.65 (GND), U5.2 (GND), U6.8 (GND), U6.15 (~OE), U7.13 (GND), U7.17 (GND), U8.13 (GND), U8.17 (GND)
HALL_HL: J8.5, R32.2, U4.33 (IO37)
HALL_HR: J9.5, R34.2, U4.38 (IO42)
HALL_VL: J6.5, R28.2, U4.31 (IO35)
HALL_VR: J7.5, R30.2, U4.32 (IO36)
IO26: TP3.1, U4.26 (IO26)
ISEN_LA: R14.1, U7.3 (AISEN)
ISEN_LB: R15.1, U7.6 (BISEN)
ISEN_RA: R16.1, U8.3 (AISEN)
ISEN_RB: R17.1, U8.6 (BISEN)
LDO_IN: C7.1, D2.1 (K), D3.1 (K), U2.3 (VI)
LED_A: LED1.2 (A), R5.2
LED_STAT: R5.1, U4.7 (IO3)
MUXB_1: R10.2, U6.3
MUXB_2: R11.2, U6.6
MUXB_3: R12.2, U6.10
MUXB_4: R13.2, U6.13
MUX_S: R8.2, R9.1, U6.1 (S)
MUX_SEL: R8.1, U4.16 (IO12)
N20_HL_A: J8.7, U7.7 (BOUT1)
N20_HL_B: J8.8, U7.5 (BOUT2)
N20_HR_A: J9.8, U8.7 (BOUT1)
N20_HR_B: J9.7, U8.5 (BOUT2)
N20_L_AIN1: U4.17 (IO13), U7.16 (AIN1)
N20_L_AIN2: U4.18 (IO14), U7.15 (AIN2)
N20_L_BIN1: U4.19 (IO15), U7.9 (BIN1)
N20_L_BIN2: U4.20 (IO16), U7.10 (BIN2)
N20_R_AIN1: U4.34 (IO38), U8.16 (AIN1)
N20_R_AIN2: U4.35 (IO39), U8.15 (AIN2)
N20_R_BIN1: U4.36 (IO40), U8.9 (BIN1)
N20_R_BIN2: U4.37 (IO41), U8.10 (BIN2)
N20_VL_A: J6.8, U7.2 (AOUT1)
N20_VL_B: J6.7, U7.4 (AOUT2)
N20_VR_A: J7.8, U8.2 (AOUT1)
N20_VR_B: J7.7, U8.4 (AOUT2)
RXD0: TP2.1, U4.40 (RXD0)
TXD0: TP1.1, U4.39 (TXD0)
USB_CC1: J2.A5 (CC1), R6.1
USB_CC2: J2.B5 (CC2), R7.1
USB_DN: J2.A7 (D-), J2.B7 (D-), U4.23 (USB_D-), U5.3 (I/O2), U5.4 (I/O2)
USB_DP: J2.B6 (D+), U4.24 (USB_D+), U5.6 (I/O1)
USB_DP_A: J2.A6 (D+), U5.1 (I/O1)
VBAT: C1.1, C2.1, C3.1, D1.1 (A1), F1.1, J1.1, R36.1, U1.2 (EN), U1.3 (IN)
VBAT_F: D4.1 (K), D5.1 (K), D6.1 (K), D7.1 (K), F1.2, J6.1, J7.1, J8.1, J9.1
VBAT_SENSE: C28.1, R36.2, R37.1, U4.10 (IO6)
VBUS: D3.2 (A), J2.A4 (VBUS), J2.A9 (VBUS), J2.B4 (VBUS), J2.B9 (VBUS), U5.5 (VBUS)
VCP_L: C16.1, U7.11 (VCP)
VCP_R: C20.1, U8.11 (VCP)
VINT_L: C17.1, U7.14 (VINT)
VINT_R: C21.1, U8.14 (VINT)

Notes on the sheet:
1 Stromversorgung: 3S-4S -> 6 V (Klappmotoren) -> 3,3 V (ESP32); 3,3 V Umschalter aus FC-5 V
2 Mikrocontroller ESP32-S3-MINI-1 (USB-C zum Flashen)
3 Motorsignal-Umschalter: FC (Flug) oder ESP32 (Fahrt) -> ESC
4 Klappmotoren: 2x DRV8833, Strombegrenzung ca. 1 A (0,2 Ohm)
5 Hubmagnet-Treiber (Kupplung), PWM: Anzug 100 %, Halten ca. 30 %
6 Sensoreingaenge: Hall (Muffe), Winkel AS5600 (Klappgelenk), Akkuspannung
7 Steckverbinder
Ecken-Stecker J6-J9: 1 Spule+ (VBAT_F) 2 Spule- 3 +3V3 4 GND 5 Hall Muffe 6 Winkel AS5600 7/8 N20-Motor (bei VL, VR, HR vertauscht: Richtung per Firmware)
FC-UART J5: MSP @115200, ESP32 liest RC-Kanaele + Arm-Status. ESC-Kabel J3/J4 werden 1:1 durchgeschleift, nur M1-M4 laufen ueber U6.

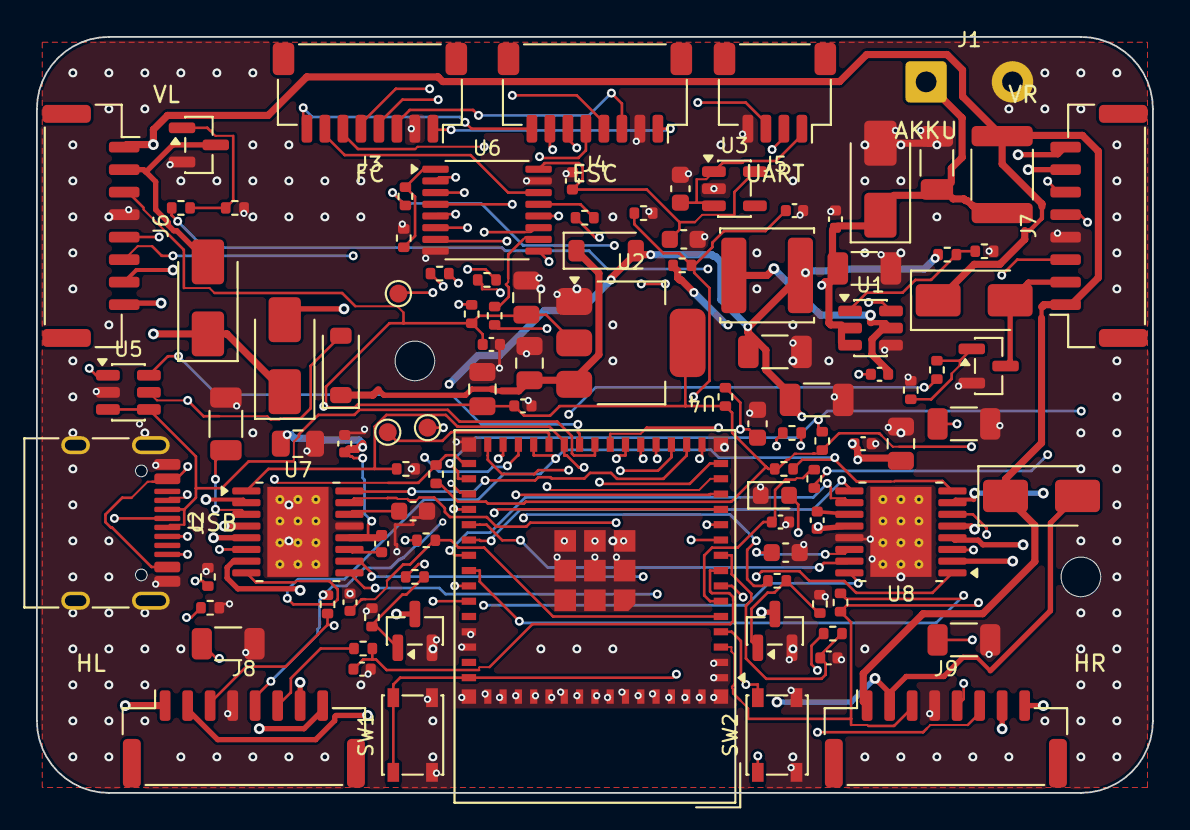
[picture p17: board Hybrid-Controller.kicad_pcb from above]

Board: 4 copper layers, 62.0 x 42.0 mm, 103 parts (0 on the bottom side), 98 nets.

Other parts of the board:
H1, H2: MountingHole_2.2mm_M2
